Jdawg0309/CustomCPU/clockInfo.txt

-------------------------------------
| Tool Version : Vivado v.2026.1
| Date         : Mon Aug 31 18:38:04 2026
| Host         : junaet-desktop
| Design       : design_1
| Device       : xc7k480t-ffg901-2--
-------------------------------------

For more information on clockInfo.txt clock routing debug file see https://support.xilinx.com/s/article/000035660?language=en_US
