Jdawg0309/CustomCPU/build/harness_report.xlsx

Sheet: Summary
test | status | words | oracle_halted | hw_halted | ram_words_touched | mismatch_count | gaps | file
t01_loops_arrays | PASS | 82 | TRUE | TRUE | 12 | 0 |  | c_tests/aggressive/t01_loops_arrays.c
t02_bitops | PASS | 94 | TRUE | TRUE | 11 | 0 |  | c_tests/aggressive/t02_bitops.c
t03_recursion | HW_TIMEOUT | 98 | TRUE | FALSE | 38 | 18 | multiply | c_tests/aggressive/t03_recursion.c
t04_structs | PASS | 133 | TRUE | TRUE | 41 | 0 |  | c_tests/aggressive/t04_structs.c
t05_sorting | PASS | 156 | TRUE | TRUE | 29 | 0 |  | c_tests/aggressive/t05_sorting.c
t06_bytes_strings | DIFFER | 165 | TRUE | TRUE | 20 | 6 |  | c_tests/aggressive/t06_bytes_strings.c
t07_signed_math | PASS | 122 | TRUE | TRUE | 19 | 0 |  | c_tests/aggressive/t07_signed_math.c
t08_deep_calls | PASS | 79 | TRUE | TRUE | 7 | 0 |  | c_tests/aggressive/t08_deep_calls.c
t09_conditionals | PASS | 187 | TRUE | TRUE | 24 | 0 |  | c_tests/aggressive/t09_conditionals.c
t10_constants_pointers | PASS | 119 | TRUE | TRUE | 24 | 0 |  | c_tests/aggressive/t10_constants_pointers.c

Sheet: RAM diffs
test | ram_word | bus_addr | oracle | hardware | known_gap
t03_recursion | 0x00 | 0x1000 | 0x00000037 | 0x00000000 | multiply
t03_recursion | 0x02 | 0x1008 | 0x00000001 | 0x00000000 | multiply
t03_recursion | 0x03 | 0x100c | 0x00000078 | 0x00000000 | multiply
t03_recursion | 0x04 | 0x1010 | 0x00000001 | 0x00000000 | multiply
t03_recursion | 0x05 | 0x1014 | 0x00000006 | 0x00000000 | multiply
t03_recursion | 0x06 | 0x1018 | 0x00000015 | 0x00000000 | multiply
t03_recursion | 0xe7 | 0x139c | 0x00000002 | 0x00000004 | multiply
t03_recursion | 0xe8 | 0x13a0 | 0x00000000 | 0x00000002 | multiply
t03_recursion | 0xea | 0x13a8 | 0x00000003 | 0x00000005 | multiply
t03_recursion | 0xeb | 0x13ac | 0x00000003 | 0x00000005 | multiply
t03_recursion | 0xee | 0x13b8 | 0x00000002 | 0x00000006 | multiply
t03_recursion | 0xef | 0x13bc | 0x00000002 | 0x00000006 | multiply
t03_recursion | 0xf2 | 0x13c8 | 0x00000003 | 0x00000007 | multiply
t03_recursion | 0xf3 | 0x13cc | 0x00000003 | 0x00000007 | multiply
t03_recursion | 0xf6 | 0x13d8 | 0x00000002 | 0x00000008 | multiply
t03_recursion | 0xf8 | 0x13e0 | 0x00000036 | 0x00000022 | multiply
t03_recursion | 0xfa | 0x13e8 | 0x00001000 | 0x00000000 | multiply
t03_recursion | 0xfd | 0x13f4 | 0x00000094 | 0x00000070 | multiply
t06_bytes_strings | 0x00 | 0x1000 | 0x0000002b | 0x0000002c
t06_bytes_strings | 0x01 | 0x1004 | 0x0000002b | 0x0000002c
t06_bytes_strings | 0x02 | 0x1008 | 0x00000000 | 0xdf9a9800
t06_bytes_strings | 0x04 | 0x1010 | 0xfebfccb9 | 0x42255dec
t06_bytes_strings | 0x05 | 0x1014 | 0x00000022 | 0x00000028
t06_bytes_strings | 0xea | 0x13a8 | 0x20656854 | 0x00000054

Sheet: Known-gap hits
test | status | words | oracle_halted | hw_halted | ram_words_touched | mismatch_count | gaps | file
t03_recursion | HW_TIMEOUT | 98 | TRUE | FALSE | 38 | 18 | multiply | c_tests/aggressive/t03_recursion.c

Sheet: Compile errors
test | detail | file
