Jdawg0309/CustomCPU/build/isa_matrix_report.xlsx

Sheet: Summary
category | total | pass | fail
loadstore_lanes | 24 | 3 | 21
multiply | 28 | 4 | 24

Sheet: loadstore_lanes
case | status | detail | asm
ldrb_ram_lane0 | DIFFER | word 0x1: oracle=0x000000dd hw=0xaabbccdd | mov r1, #0x1000 ldr r2, =0xaabbccdd str r2, [r1] ldrb r0, [r1, #0] str r0, [r1, #4]
ldrb_rom_lane0 | DIFFER | word 0x1: oracle=0x000000dd hw=0xaabbccdd | ldr r1, =lit_word ldrb r0, [r1, #0] mov r4, #0x1000 str r0, [r4, #4] b 1f lit_word: .word 0xaabbccdd 1:
ldrb_ram_lane1 | DIFFER | word 0x1: oracle=0x000000cc hw=0xaabbccdd | mov r1, #0x1000 ldr r2, =0xaabbccdd str r2, [r1] ldrb r0, [r1, #1] str r0, [r1, #4]
ldrb_rom_lane1 | DIFFER | word 0x1: oracle=0x000000cc hw=0xaabbccdd | ldr r1, =lit_word ldrb r0, [r1, #1] mov r4, #0x1000 str r0, [r4, #4] b 1f lit_word: .word 0xaabbccdd 1:
ldrb_ram_lane2 | DIFFER | word 0x1: oracle=0x000000bb hw=0xaabbccdd | mov r1, #0x1000 ldr r2, =0xaabbccdd str r2, [r1] ldrb r0, [r1, #2] str r0, [r1, #4]
ldrb_rom_lane2 | DIFFER | word 0x1: oracle=0x000000bb hw=0xaabbccdd | ldr r1, =lit_word ldrb r0, [r1, #2] mov r4, #0x1000 str r0, [r4, #4] b 1f lit_word: .word 0xaabbccdd 1:
ldrb_ram_lane3 | DIFFER | word 0x1: oracle=0x000000aa hw=0xaabbccdd | mov r1, #0x1000 ldr r2, =0xaabbccdd str r2, [r1] ldrb r0, [r1, #3] str r0, [r1, #4]
ldrb_rom_lane3 | DIFFER | word 0x1: oracle=0x000000aa hw=0xaabbccdd | ldr r1, =lit_word ldrb r0, [r1, #3] mov r4, #0x1000 str r0, [r4, #4] b 1f lit_word: .word 0xaabbccdd 1:
strb_lane0 | PASS |  | mov r1, #0x1000 mov r2, #0 str r2, [r1] mov r3, #0x5A strb r3, [r1, #0] ldr r0, [r1] str r0, [r1, #4]
strb_lane1 | DIFFER | word 0x0: oracle=0x00005a00 hw=0x0000005a; word 0x1: oracle=0x00005a00 hw=0x0000005a | mov r1, #0x1000 mov r2, #0 str r2, [r1] mov r3, #0x5A strb r3, [r1, #1] ldr r0, [r1] str r0, [r1, #4]
strb_lane2 | DIFFER | word 0x0: oracle=0x005a0000 hw=0x0000005a; word 0x1: oracle=0x005a0000 hw=0x0000005a | mov r1, #0x1000 mov r2, #0 str r2, [r1] mov r3, #0x5A strb r3, [r1, #2] ldr r0, [r1] str r0, [r1, #4]
strb_lane3 | DIFFER | word 0x0: oracle=0x5a000000 hw=0x0000005a; word 0x1: oracle=0x5a000000 hw=0x0000005a | mov r1, #0x1000 mov r2, #0 str r2, [r1] mov r3, #0x5A strb r3, [r1, #3] ldr r0, [r1] str r0, [r1, #4]
ldrh_ram_lane0 | DIFFER | word 0x0: oracle=0xaabbccdd hw=0x0000aabb; word 0x1: oracle=0x0000ccdd hw=0x0000aabb | mov r1, #0x1000 ldr r2, =0xaabbccdd str r2, [r1] ldrh r0, [r1, #0] str r0, [r1, #4]
strh_lane0 | DIFFER | word 0x0: oracle=0x00001234 hw=0x12340000; word 0x1: oracle=0x00001234 hw=0x12340000 | mov r1, #0x1000 mov r2, #0 str r2, [r1] ldr r3, =0x1234 strh r3, [r1, #0] ldr r0, [r1] str r0, [r1, #4]
ldrh_ram_lane2 | DIFFER | word 0x0: oracle=0xaabbccdd hw=0xccddccdd; word 0x1: oracle=0x0000aabb hw=0x0000ccdd | mov r1, #0x1000 ldr r2, =0xaabbccdd str r2, [r1] ldrh r0, [r1, #2] str r0, [r1, #4]
strh_lane2 | DIFFER | word 0x0: oracle=0x12340000 hw=0x00001234; word 0x1: oracle=0x12340000 hw=0x00001234 | mov r1, #0x1000 mov r2, #0 str r2, [r1] ldr r3, =0x1234 strh r3, [r1, #2] ldr r0, [r1] str r0, [r1, #4]
ldrsb_lane0 | DIFFER | word 0x0: oracle=0x81828384 hw=0x00008182; word 0x1: oracle=0xffffff84 hw=0xffffff82 | mov r1, #0x1000 ldr r2, =0x81828384 str r2, [r1] ldrsb r0, [r1, #0] str r0, [r1, #4]
ldrsb_lane1 | DIFFER | word 0x0: oracle=0x81828384 hw=0x10008182; word 0x1: oracle=0xffffff83 hw=0xffffff81 | mov r1, #0x1000 ldr r2, =0x81828384 str r2, [r1] ldrsb r0, [r1, #1] str r0, [r1, #4]
ldrsb_lane2 | DIFFER | word 0x0: oracle=0x81828384 hw=0x83848384; word 0x1: oracle=0xffffff82 hw=0xffffff84 | mov r1, #0x1000 ldr r2, =0x81828384 str r2, [r1] ldrsb r0, [r1, #2] str r0, [r1, #4]
ldrsb_lane3 | DIFFER | word 0x0: oracle=0x81828384 hw=0x83840000; word 0x1: oracle=0xffffff81 hw=0xffffff83 | mov r1, #0x1000 ldr r2, =0x81828384 str r2, [r1] ldrsb r0, [r1, #3] str r0, [r1, #4]
ldrsh_lane0 | DIFFER | word 0x0: oracle=0x81828384 hw=0x00008182; word 0x1: oracle=0xffff8384 hw=0xffff8182 | mov r1, #0x1000 ldr r2, =0x81828384 str r2, [r1] ldrsh r0, [r1, #0] str r0, [r1, #4]
ldrsh_lane2 | DIFFER | word 0x0: oracle=0x81828384 hw=0x83848384; word 0x1: oracle=0xffff8182 hw=0xffff8384 | mov r1, #0x1000 ldr r2, =0x81828384 str r2, [r1] ldrsh r0, [r1, #2] str r0, [r1, #4]
strb_preindex_writeback | PASS |  | mov r1, #0x1000 add r1, r1, #4 mov r2, #0xAB strb r2, [r1, #-4]! mov r4, #0x1000 str r1, [r4, #8] ldr r0, [r1] str r0, [r4, #12]
strb_postindex | PASS |  | mov r1, #0x1000 mov r2, #0xCD strb r2, [r1], #4 mov r4, #0x1000 str r1, [r4, #8] ldr r0, [r1, #-4] str r0, [r4, #12]

Sheet: multiply
case | status | detail | asm
mul_0x7_0x6 | DIFFER | word 0x0: oracle=0x0000002a hw=0x00000000 | ldr r1, =0x00000007 ldr r2, =0x00000006 mul r0, r1, r2 mov r4, #0x1000 str r0, [r4]
mla_0x7_0x6 | DIFFER | word 0x0: oracle=0x0000102a hw=0x000001c0 | ldr r1, =0x00000007 ldr r2, =0x00000006 ldr r3, =0x1000 mla r0, r1, r2, r3 mov r4, #0x1000 str r0, [r4]
umull_0x7_0x6 | DIFFER | word 0x0: oracle=0x0000002a hw=0x000001c0 | ldr r2, =0x00000007 ldr r3, =0x00000006 umull r0, r1, r2, r3 mov r4, #0x1000 str r0, [r4] str r1, [r4, #4]
smull_0x7_0x6 | DIFFER | word 0x0: oracle=0x0000002a hw=0xfffffe3f | ldr r2, =0x00000007 ldr r3, =0x00000006 smull r0, r1, r2, r3 mov r4, #0x1000 str r0, [r4] str r1, [r4, #4]
mul_0x0_0x5 | PASS |  | ldr r1, =0x00000000 ldr r2, =0x00000005 mul r0, r1, r2 mov r4, #0x1000 str r0, [r4]
mla_0x0_0x5 | DIFFER | word 0x0: oracle=0x00001000 hw=0x00000000 | ldr r1, =0x00000000 ldr r2, =0x00000005 ldr r3, =0x1000 mla r0, r1, r2, r3 mov r4, #0x1000 str r0, [r4]
umull_0x0_0x5 | PASS |  | ldr r2, =0x00000000 ldr r3, =0x00000005 umull r0, r1, r2, r3 mov r4, #0x1000 str r0, [r4] str r1, [r4, #4]
smull_0x0_0x5 | DIFFER | word 0x0: oracle=0x00000000 hw=0xffffffff | ldr r2, =0x00000000 ldr r3, =0x00000005 smull r0, r1, r2, r3 mov r4, #0x1000 str r0, [r4] str r1, [r4, #4]
mul_0xffffffff_0x2 | DIFFER | word 0x0: oracle=0xfffffffe hw=0x00000000 | ldr r1, =0xffffffff ldr r2, =0x00000002 mul r0, r1, r2 mov r4, #0x1000 str r0, [r4]
mla_0xffffffff_0x2 | DIFFER | word 0x0: oracle=0x00000ffe hw=0xfffffffc | ldr r1, =0xffffffff ldr r2, =0x00000002 ldr r3, =0x1000 mla r0, r1, r2, r3 mov r4, #0x1000 str r0, [r4]
umull_0xffffffff_0x2 | DIFFER | word 0x0: oracle=0xfffffffe hw=0xfffffffc; word 0x1: oracle=0x00000001 hw=0x00000000 | ldr r2, =0xffffffff ldr r3, =0x00000002 umull r0, r1, r2, r3 mov r4, #0x1000 str r0, [r4] str r1, [r4, #4]
smull_0xffffffff_0x2 | DIFFER | word 0x0: oracle=0xfffffffe hw=0x00000003; word 0x1: oracle=0xffffffff hw=0x00000000 | ldr r2, =0xffffffff ldr r3, =0x00000002 smull r0, r1, r2, r3 mov r4, #0x1000 str r0, [r4] str r1, [r4, #4]
mul_0x80000000_0x2 | PASS |  | ldr r1, =0x80000000 ldr r2, =0x00000002 mul r0, r1, r2 mov r4, #0x1000 str r0, [r4]
mla_0x80000000_0x2 | DIFFER | word 0x0: oracle=0x00001000 hw=0x00000000 | ldr r1, =0x80000000 ldr r2, =0x00000002 ldr r3, =0x1000 mla r0, r1, r2, r3 mov r4, #0x1000 str r0, [r4]
umull_0x80000000_0x2 | DIFFER | word 0x1: oracle=0x00000001 hw=0x00000000 | ldr r2, =0x80000000 ldr r3, =0x00000002 umull r0, r1, r2, r3 mov r4, #0x1000 str r0, [r4] str r1, [r4, #4]
smull_0x80000000_0x2 | DIFFER | word 0x0: oracle=0x00000000 hw=0xffffffff; word 0x1: oracle=0xffffffff hw=0x00000000 | ldr r2, =0x80000000 ldr r3, =0x00000002 smull r0, r1, r2, r3 mov r4, #0x1000 str r0, [r4] str r1, [r4, #4]
mul_0x80000000_0x80000000 | PASS |  | ldr r1, =0x80000000 ldr r2, =0x80000000 mul r0, r1, r2 mov r4, #0x1000 str r0, [r4]
mla_0x80000000_0x80000000 | DIFFER | word 0x0: oracle=0x00001000 hw=0x80000000 | ldr r1, =0x80000000 ldr r2, =0x80000000 ldr r3, =0x1000 mla r0, r1, r2, r3 mov r4, #0x1000 str r0, [r4]
umull_0x80000000_0x80000000 | DIFFER | word 0x0: oracle=0x00000000 hw=0x80000000; word 0x1: oracle=0x40000000 hw=0x00000000 | ldr r2, =0x80000000 ldr r3, =0x80000000 umull r0, r1, r2, r3 mov r4, #0x1000 str r0, [r4] str r1, [r4, #4]
smull_0x80000000_0x80000000 | DIFFER | word 0x0: oracle=0x00000000 hw=0x7fffffff; word 0x1: oracle=0x40000000 hw=0x00000000 | ldr r2, =0x80000000 ldr r3, =0x80000000 smull r0, r1, r2, r3 mov r4, #0x1000 str r0, [r4] str r1, [r4, #4]
mul_0xffffffff_0xffffffff | DIFFER | word 0x0: oracle=0x00000001 hw=0x00000000 | ldr r1, =0xffffffff ldr r2, =0xffffffff mul r0, r1, r2 mov r4, #0x1000 str r0, [r4]
mla_0xffffffff_0xffffffff | DIFFER | word 0x0: oracle=0x00001001 hw=0x00000000 | ldr r1, =0xffffffff ldr r2, =0xffffffff ldr r3, =0x1000 mla r0, r1, r2, r3 mov r4, #0x1000 str r0, [r4]
umull_0xffffffff_0xffffffff | DIFFER | word 0x0: oracle=0x00000001 hw=0x00000000; word 0x1: oracle=0xfffffffe hw=0x00000000 | ldr r2, =0xffffffff ldr r3, =0xffffffff umull r0, r1, r2, r3 mov r4, #0x1000 str r0, [r4] str r1, [r4, #4]
smull_0xffffffff_0xffffffff | DIFFER | word 0x0: oracle=0x00000001 hw=0xffffffff | ldr r2, =0xffffffff ldr r3, =0xffffffff smull r0, r1, r2, r3 mov r4, #0x1000 str r0, [r4] str r1, [r4, #4]
mul_0x186a0_0x186a0 | DIFFER | word 0x0: oracle=0x540be400 hw=0x00000000 | ldr r1, =0x000186a0 ldr r2, =0x000186a0 mul r0, r1, r2 mov r4, #0x1000 str r0, [r4]
mla_0x186a0_0x186a0 | DIFFER | word 0x0: oracle=0x540bf400 hw=0x00000000 | ldr r1, =0x000186a0 ldr r2, =0x000186a0 ldr r3, =0x1000 mla r0, r1, r2, r3 mov r4, #0x1000 str r0, [r4]
umull_0x186a0_0x186a0 | DIFFER | word 0x0: oracle=0x540be400 hw=0x00000000; word 0x1: oracle=0x00000002 hw=0x00000000 | ldr r2, =0x000186a0 ldr r3, =0x000186a0 umull r0, r1, r2, r3 mov r4, #0x1000 str r0, [r4] str r1, [r4, #4]
smull_0x186a0_0x186a0 | DIFFER | word 0x0: oracle=0x540be400 hw=0xffffffff; word 0x1: oracle=0x00000002 hw=0x00000000 | ldr r2, =0x000186a0 ldr r3, =0x000186a0 smull r0, r1, r2, r3 mov r4, #0x1000 str r0, [r4] str r1, [r4, #4]
