Jdawg0309/CustomCPU/build/isa_matrix_report2.xlsx

Sheet: Summary
category | total | pass | fail
dp_immediate | 84 | 72 | 12
shifter | 112 | 53 | 59

Sheet: dp_immediate
case | status | detail | asm
and_s_imm_0x000000ff | PASS |  | mov r1, #0x55 ands r0, r1, #0xff mov r4, #0x1000 str r0, [r4] mov r6, #0 addmi r6, r6, #8 addeq r6, r6, #4 addcs r6, r6, #2 addvs r6, r6, #1 str r6, [r4, #4]
and_s_imm_0xff000000 | DIFFER | word 0x1: oracle=0x00000006 hw=0x00000004 | mov r1, #0x55 ands r0, r1, #0xff000000 mov r4, #0x1000 str r0, [r4] mov r6, #0 addmi r6, r6, #8 addeq r6, r6, #4 addcs r6, r6, #2 addvs r6, r6, #1 str r6, [r4, #4]
and_s_imm_0x0000ff00 | PASS |  | mov r1, #0x55 ands r0, r1, #0xff00 mov r4, #0x1000 str r0, [r4] mov r6, #0 addmi r6, r6, #8 addeq r6, r6, #4 addcs r6, r6, #2 addvs r6, r6, #1 str r6, [r4, #4]
and_s_imm_0xc0000000 | DIFFER | word 0x1: oracle=0x00000006 hw=0x00000004 | mov r1, #0x55 ands r0, r1, #0xc0000000 mov r4, #0x1000 str r0, [r4] mov r6, #0 addmi r6, r6, #8 addeq r6, r6, #4 addcs r6, r6, #2 addvs r6, r6, #1 str r6, [r4, #4]
and_s_imm_0x00000001 | PASS |  | mov r1, #0x55 ands r0, r1, #0x1 mov r4, #0x1000 str r0, [r4] mov r6, #0 addmi r6, r6, #8 addeq r6, r6, #4 addcs r6, r6, #2 addvs r6, r6, #1 str r6, [r4, #4]
and_s_imm_0x40000000 | PASS |  | mov r1, #0x55 ands r0, r1, #0x40000000 mov r4, #0x1000 str r0, [r4] mov r6, #0 addmi r6, r6, #8 addeq r6, r6, #4 addcs r6, r6, #2 addvs r6, r6, #1 str r6, [r4, #4]
and_s_imm_0x00000000 | PASS |  | mov r1, #0x55 ands r0, r1, #0x0 mov r4, #0x1000 str r0, [r4] mov r6, #0 addmi r6, r6, #8 addeq r6, r6, #4 addcs r6, r6, #2 addvs r6, r6, #1 str r6, [r4, #4]
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
mov_s_imm_0x0000ff00 | PASS |  | mov r0, #0x11 movs r0, #0xff00 mov r4, #0x1000 str r0, [r4] mov r6, #0 addmi r6, r6, #8 addeq r6, r6, #4 addcs r6, r6, #2 addvs r6, r6, #1 str r6, [r4, #4]
mov_s_imm_0xc0000000 | DIFFER | word 0x1: oracle=0x0000000a hw=0x00000008 | mov r0, #0x11 movs r0, #0xc0000000 mov r4, #0x1000 str r0, [r4] mov r6, #0 addmi r6, r6, #8 addeq r6, r6, #4 addcs r6, r6, #2 addvs r6, r6, #1 str r6, [r4, #4]
mov_s_imm_0x00000001 | PASS |  | mov r0, #0x11 movs r0, #0x1 mov r4, #0x1000 str r0, [r4] mov r6, #0 addmi r6, r6, #8 addeq r6, r6, #4 addcs r6, r6, #2 addvs r6, r6, #1 str r6, [r4, #4]
mov_s_imm_0x40000000 | PASS |  | mov r0, #0x11 movs r0, #0x40000000 mov r4, #0x1000 str r0, [r4] mov r6, #0 addmi r6, r6, #8 addeq r6, r6, #4 addcs r6, r6, #2 addvs r6, r6, #1 str r6, [r4, #4]
mov_s_imm_0x00000000 | PASS |  | mov r0, #0x11 movs r0, #0x0 mov r4, #0x1000 str r0, [r4] mov r6, #0 addmi r6, r6, #8 addeq r6, r6, #4 addcs r6, r6, #2 addvs r6, r6, #1 str r6, [r4, #4]
mvn_s_imm_0x000000ff | PASS |  | mov r0, #0x11 mvns r0, #0xff mov r4, #0x1000 str r0, [r4] mov r6, #0 addmi r6, r6, #8 addeq r6, r6, #4 addcs r6, r6, #2 addvs r6, r6, #1 str r6, [r4, #4]
mvn_s_imm_0xff000000 | DIFFER | word 0x1: oracle=0x00000002 hw=0x00000000 | mov r0, #0x11 mvns r0, #0xff000000 mov r4, #0x1000 str r0, [r4] mov r6, #0 addmi r6, r6, #8 addeq r6, r6, #4 addcs r6, r6, #2 addvs r6, r6, #1 str r6, [r4, #4]
mvn_s_imm_0x0000ff00 | PASS |  | mov r0, #0x11 mvns r0, #0xff00 mov r4, #0x1000 str r0, [r4] mov r6, #0 addmi r6, r6, #8 addeq r6, r6, #4 addcs r6, r6, #2 addvs r6, r6, #1 str r6, [r4, #4]
mvn_s_imm_0xc0000000 | DIFFER | word 0x1: oracle=0x00000002 hw=0x00000000 | mov r0, #0x11 mvns r0, #0xc0000000 mov r4, #0x1000 str r0, [r4] mov r6, #0 addmi r6, r6, #8 addeq r6, r6, #4 addcs r6, r6, #2 addvs r6, r6, #1 str r6, [r4, #4]
mvn_s_imm_0x00000001 | PASS |  | mov r0, #0x11 mvns r0, #0x1 mov r4, #0x1000 str r0, [r4] mov r6, #0 addmi r6, r6, #8 addeq r6, r6, #4 addcs r6, r6, #2 addvs r6, r6, #1 str r6, [r4, #4]
mvn_s_imm_0x40000000 | PASS |  | mov r0, #0x11 mvns r0, #0x40000000 mov r4, #0x1000 str r0, [r4] mov r6, #0 addmi r6, r6, #8 addeq r6, r6, #4 addcs r6, r6, #2 addvs r6, r6, #1 str r6, [r4, #4]
mvn_s_imm_0x00000000 | PASS |  | mov r0, #0x11 mvns r0, #0x0 mov r4, #0x1000 str r0, [r4] mov r6, #0 addmi r6, r6, #8 addeq r6, r6, #4 addcs r6, r6, #2 addvs r6, r6, #1 str r6, [r4, #4]

Sheet: shifter
case | status | detail | asm
movs_lsl_0_0x9a3c55f1 | PASS |  | ldr r1, =0x9a3c55f1 movs r0, r1, lsl #0 mov r4, #0x1000 str r0, [r4] mov r6, #0 addmi r6, r6, #8 addeq r6, r6, #4 addcs r6, r6, #2 addvs r6, r6, #1 str r6, [r4, #4]
movs_lsl_0_0xffffffff | PASS |  | ldr r1, =0xffffffff movs r0, r1, lsl #0 mov r4, #0x1000 str r0, [r4] mov r6, #0 addmi r6, r6, #8 addeq r6, r6, #4 addcs r6, r6, #2 addvs r6, r6, #1 str r6, [r4, #4]
movs_lsl_0_0x00000001 | PASS |  | ldr r1, =0x00000001 movs r0, r1, lsl #0 mov r4, #0x1000 str r0, [r4] mov r6, #0 addmi r6, r6, #8 addeq r6, r6, #4 addcs r6, r6, #2 addvs r6, r6, #1 str r6, [r4, #4]
movs_lsl_0_0x80000000 | PASS |  | ldr r1, =0x80000000 movs r0, r1, lsl #0 mov r4, #0x1000 str r0, [r4] mov r6, #0 addmi r6, r6, #8 addeq r6, r6, #4 addcs r6, r6, #2 addvs r6, r6, #1 str r6, [r4, #4]
movs_lsl_1_0x9a3c55f1 | DIFFER | word 0x1: oracle=0x00000002 hw=0x00000000 | ldr r1, =0x9a3c55f1 movs r0, r1, lsl #1 mov r4, #0x1000 str r0, [r4] mov r6, #0 addmi r6, r6, #8 addeq r6, r6, #4 addcs r6, r6, #2 addvs r6, r6, #1 str r6, [r4, #4]
movs_lsl_1_0xffffffff | DIFFER | word 0x1: oracle=0x0000000a hw=0x00000008 | ldr r1, =0xffffffff movs r0, r1, lsl #1 mov r4, #0x1000 str r0, [r4] mov r6, #0 addmi r6, r6, #8 addeq r6, r6, #4 addcs r6, r6, #2 addvs r6, r6, #1 str r6, [r4, #4]
movs_lsl_1_0x00000001 | PASS |  | ldr r1, =0x00000001 movs r0, r1, lsl #1 mov r4, #0x1000 str r0, [r4] mov r6, #0 addmi r6, r6, #8 addeq r6, r6, #4 addcs r6, r6, #2 addvs r6, r6, #1 str r6, [r4, #4]
movs_lsl_1_0x80000000 | DIFFER | word 0x1: oracle=0x00000006 hw=0x00000004 | ldr r1, =0x80000000 movs r0, r1, lsl #1 mov r4, #0x1000 str r0, [r4] mov r6, #0 addmi r6, r6, #8 addeq r6, r6, #4 addcs r6, r6, #2 addvs r6, r6, #1 str r6, [r4, #4]
movs_lsl_31_0x9a3c55f1 | PASS |  | ldr r1, =0x9a3c55f1 movs r0, r1, lsl #31 mov r4, #0x1000 str r0, [r4] mov r6, #0 addmi r6, r6, #8 addeq r6, r6, #4 addcs r6, r6, #2 addvs r6, r6, #1 str r6, [r4, #4]
movs_lsl_31_0xffffffff | DIFFER | word 0x1: oracle=0x0000000a hw=0x00000008 | ldr r1, =0xffffffff movs r0, r1, lsl #31 mov r4, #0x1000 str r0, [r4] mov r6, #0 addmi r6, r6, #8 addeq r6, r6, #4 addcs r6, r6, #2 addvs r6, r6, #1 str r6, [r4, #4]
movs_lsl_31_0x00000001 | PASS |  | ldr r1, =0x00000001 movs r0, r1, lsl #31 mov r4, #0x1000 str r0, [r4] mov r6, #0 addmi r6, r6, #8 addeq r6, r6, #4 addcs r6, r6, #2 addvs r6, r6, #1 str r6, [r4, #4]
movs_lsl_31_0x80000000 | PASS |  | ldr r1, =0x80000000 movs r0, r1, lsl #31 mov r4, #0x1000 str r0, [r4] mov r6, #0 addmi r6, r6, #8 addeq r6, r6, #4 addcs r6, r6, #2 addvs r6, r6, #1 str r6, [r4, #4]
movs_lsr_1_0x9a3c55f1 | DIFFER | word 0x1: oracle=0x00000002 hw=0x00000000 | ldr r1, =0x9a3c55f1 movs r0, r1, lsr #1 mov r4, #0x1000 str r0, [r4] mov r6, #0 addmi r6, r6, #8 addeq r6, r6, #4 addcs r6, r6, #2 addvs r6, r6, #1 str r6, [r4, #4]
movs_lsr_1_0xffffffff | DIFFER | word 0x1: oracle=0x00000002 hw=0x00000000 | ldr r1, =0xffffffff movs r0, r1, lsr #1 mov r4, #0x1000 str r0, [r4] mov r6, #0 addmi r6, r6, #8 addeq r6, r6, #4 addcs r6, r6, #2 addvs r6, r6, #1 str r6, [r4, #4]
movs_lsr_1_0x00000001 | DIFFER | word 0x1: oracle=0x00000006 hw=0x00000004 | ldr r1, =0x00000001 movs r0, r1, lsr #1 mov r4, #0x1000 str r0, [r4] mov r6, #0 addmi r6, r6, #8 addeq r6, r6, #4 addcs r6, r6, #2 addvs r6, r6, #1 str r6, [r4, #4]
movs_lsr_1_0x80000000 | PASS |  | ldr r1, =0x80000000 movs r0, r1, lsr #1 mov r4, #0x1000 str r0, [r4] mov r6, #0 addmi r6, r6, #8 addeq r6, r6, #4 addcs r6, r6, #2 addvs r6, r6, #1 str r6, [r4, #4]
movs_lsr_31_0x9a3c55f1 | PASS |  | ldr r1, =0x9a3c55f1 movs r0, r1, lsr #31 mov r4, #0x1000 str r0, [r4] mov r6, #0 addmi r6, r6, #8 addeq r6, r6, #4 addcs r6, r6, #2 addvs r6, r6, #1 str r6, [r4, #4]
movs_lsr_31_0xffffffff | DIFFER | word 0x1: oracle=0x00000002 hw=0x00000000 | ldr r1, =0xffffffff movs r0, r1, lsr #31 mov r4, #0x1000 str r0, [r4] mov r6, #0 addmi r6, r6, #8 addeq r6, r6, #4 addcs r6, r6, #2 addvs r6, r6, #1 str r6, [r4, #4]
movs_lsr_31_0x00000001 | PASS |  | ldr r1, =0x00000001 movs r0, r1, lsr #31 mov r4, #0x1000 str r0, [r4] mov r6, #0 addmi r6, r6, #8 addeq r6, r6, #4 addcs r6, r6, #2 addvs r6, r6, #1 str r6, [r4, #4]
movs_lsr_31_0x80000000 | PASS |  | ldr r1, =0x80000000 movs r0, r1, lsr #31 mov r4, #0x1000 str r0, [r4] mov r6, #0 addmi r6, r6, #8 addeq r6, r6, #4 addcs r6, r6, #2 addvs r6, r6, #1 str r6, [r4, #4]
movs_lsr_32_0x9a3c55f1 | DIFFER | word 0x0: oracle=0x00000000 hw=0x9a3c55f1; word 0x1: oracle=0x00000006 hw=0x00000008 | ldr r1, =0x9a3c55f1 movs r0, r1, lsr #32 mov r4, #0x1000 str r0, [r4] mov r6, #0 addmi r6, r6, #8 addeq r6, r6, #4 addcs r6, r6, #2 addvs r6, r6, #1 str r6, [r4, #4]
movs_lsr_32_0xffffffff | DIFFER | word 0x0: oracle=0x00000000 hw=0xffffffff; word 0x1: oracle=0x00000006 hw=0x00000008 | ldr r1, =0xffffffff movs r0, r1, lsr #32 mov r4, #0x1000 str r0, [r4] mov r6, #0 addmi r6, r6, #8 addeq r6, r6, #4 addcs r6, r6, #2 addvs r6, r6, #1 str r6, [r4, #4]
movs_lsr_32_0x00000001 | DIFFER | word 0x0: oracle=0x00000000 hw=0x00000001; word 0x1: oracle=0x00000004 hw=0x00000000 | ldr r1, =0x00000001 movs r0, r1, lsr #32 mov r4, #0x1000 str r0, [r4] mov r6, #0 addmi r6, r6, #8 addeq r6, r6, #4 addcs r6, r6, #2 addvs r6, r6, #1 str r6, [r4, #4]
movs_lsr_32_0x80000000 | DIFFER | word 0x0: oracle=0x00000000 hw=0x80000000; word 0x1: oracle=0x00000006 hw=0x00000008 | ldr r1, =0x80000000 movs r0, r1, lsr #32 mov r4, #0x1000 str r0, [r4] mov r6, #0 addmi r6, r6, #8 addeq r6, r6, #4 addcs r6, r6, #2 addvs r6, r6, #1 str r6, [r4, #4]
movs_asr_1_0x9a3c55f1 | DIFFER | word 0x1: oracle=0x0000000a hw=0x00000008 | ldr r1, =0x9a3c55f1 movs r0, r1, asr #1 mov r4, #0x1000 str r0, [r4] mov r6, #0 addmi r6, r6, #8 addeq r6, r6, #4 addcs r6, r6, #2 addvs r6, r6, #1 str r6, [r4, #4]
movs_asr_1_0xffffffff | DIFFER | word 0x1: oracle=0x0000000a hw=0x00000008 | ldr r1, =0xffffffff movs r0, r1, asr #1 mov r4, #0x1000 str r0, [r4] mov r6, #0 addmi r6, r6, #8 addeq r6, r6, #4 addcs r6, r6, #2 addvs r6, r6, #1 str r6, [r4, #4]
movs_asr_1_0x00000001 | DIFFER | word 0x1: oracle=0x00000006 hw=0x00000004 | ldr r1, =0x00000001 movs r0, r1, asr #1 mov r4, #0x1000 str r0, [r4] mov r6, #0 addmi r6, r6, #8 addeq r6, r6, #4 addcs r6, r6, #2 addvs r6, r6, #1 str r6, [r4, #4]
movs_asr_1_0x80000000 | PASS |  | ldr r1, =0x80000000 movs r0, r1, asr #1 mov r4, #0x1000 str r0, [r4] mov r6, #0 addmi r6, r6, #8 addeq r6, r6, #4 addcs r6, r6, #2 addvs r6, r6, #1 str r6, [r4, #4]
movs_asr_31_0x9a3c55f1 | PASS |  | ldr r1, =0x9a3c55f1 movs r0, r1, asr #31 mov r4, #0x1000 str r0, [r4] mov r6, #0 addmi r6, r6, #8 addeq r6, r6, #4 addcs r6, r6, #2 addvs r6, r6, #1 str r6, [r4, #4]
movs_asr_31_0xffffffff | DIFFER | word 0x1: oracle=0x0000000a hw=0x00000008 | ldr r1, =0xffffffff movs r0, r1, asr #31 mov r4, #0x1000 str r0, [r4] mov r6, #0 addmi r6, r6, #8 addeq r6, r6, #4 addcs r6, r6, #2 addvs r6, r6, #1 str r6, [r4, #4]
movs_asr_31_0x00000001 | PASS |  | ldr r1, =0x00000001 movs r0, r1, asr #31 mov r4, #0x1000 str r0, [r4] mov r6, #0 addmi r6, r6, #8 addeq r6, r6, #4 addcs r6, r6, #2 addvs r6, r6, #1 str r6, [r4, #4]
movs_asr_31_0x80000000 | PASS |  | ldr r1, =0x80000000 movs r0, r1, asr #31 mov r4, #0x1000 str r0, [r4] mov r6, #0 addmi r6, r6, #8 addeq r6, r6, #4 addcs r6, r6, #2 addvs r6, r6, #1 str r6, [r4, #4]
movs_asr_32_0x9a3c55f1 | DIFFER | word 0x0: oracle=0xffffffff hw=0x9a3c55f1; word 0x1: oracle=0x0000000a hw=0x00000008 | ldr r1, =0x9a3c55f1 movs r0, r1, asr #32 mov r4, #0x1000 str r0, [r4] mov r6, #0 addmi r6, r6, #8 addeq r6, r6, #4 addcs r6, r6, #2 addvs r6, r6, #1 str r6, [r4, #4]
movs_asr_32_0xffffffff | DIFFER | word 0x1: oracle=0x0000000a hw=0x00000008 | ldr r1, =0xffffffff movs r0, r1, asr #32 mov r4, #0x1000 str r0, [r4] mov r6, #0 addmi r6, r6, #8 addeq r6, r6, #4 addcs r6, r6, #2 addvs r6, r6, #1 str r6, [r4, #4]
movs_asr_32_0x00000001 | DIFFER | word 0x0: oracle=0x00000000 hw=0x00000001; word 0x1: oracle=0x00000004 hw=0x00000000 | ldr r1, =0x00000001 movs r0, r1, asr #32 mov r4, #0x1000 str r0, [r4] mov r6, #0 addmi r6, r6, #8 addeq r6, r6, #4 addcs r6, r6, #2 addvs r6, r6, #1 str r6, [r4, #4]
movs_asr_32_0x80000000 | DIFFER | word 0x0: oracle=0xffffffff hw=0x80000000; word 0x1: oracle=0x0000000a hw=0x00000008 | ldr r1, =0x80000000 movs r0, r1, asr #32 mov r4, #0x1000 str r0, [r4] mov r6, #0 addmi r6, r6, #8 addeq r6, r6, #4 addcs r6, r6, #2 addvs r6, r6, #1 str r6, [r4, #4]
movs_ror_1_0x9a3c55f1 | DIFFER | word 0x1: oracle=0x0000000a hw=0x00000008 | ldr r1, =0x9a3c55f1 movs r0, r1, ror #1 mov r4, #0x1000 str r0, [r4] mov r6, #0 addmi r6, r6, #8 addeq r6, r6, #4 addcs r6, r6, #2 addvs r6, r6, #1 str r6, [r4, #4]
movs_ror_1_0xffffffff | DIFFER | word 0x1: oracle=0x0000000a hw=0x00000008 | ldr r1, =0xffffffff movs r0, r1, ror #1 mov r4, #0x1000 str r0, [r4] mov r6, #0 addmi r6, r6, #8 addeq r6, r6, #4 addcs r6, r6, #2 addvs r6, r6, #1 str r6, [r4, #4]
movs_ror_1_0x00000001 | DIFFER | word 0x1: oracle=0x0000000a hw=0x00000008 | ldr r1, =0x00000001 movs r0, r1, ror #1 mov r4, #0x1000 str r0, [r4] mov r6, #0 addmi r6, r6, #8 addeq r6, r6, #4 addcs r6, r6, #2 addvs r6, r6, #1 str r6, [r4, #4]
movs_ror_1_0x80000000 | PASS |  | ldr r1, =0x80000000 movs r0, r1, ror #1 mov r4, #0x1000 str r0, [r4] mov r6, #0 addmi r6, r6, #8 addeq r6, r6, #4 addcs r6, r6, #2 addvs r6, r6, #1 str r6, [r4, #4]
movs_ror_31_0x9a3c55f1 | PASS |  | ldr r1, =0x9a3c55f1 movs r0, r1, ror #31 mov r4, #0x1000 str r0, [r4] mov r6, #0 addmi r6, r6, #8 addeq r6, r6, #4 addcs r6, r6, #2 addvs r6, r6, #1 str r6, [r4, #4]
movs_ror_31_0xffffffff | DIFFER | word 0x1: oracle=0x0000000a hw=0x00000008 | ldr r1, =0xffffffff movs r0, r1, ror #31 mov r4, #0x1000 str r0, [r4] mov r6, #0 addmi r6, r6, #8 addeq r6, r6, #4 addcs r6, r6, #2 addvs r6, r6, #1 str r6, [r4, #4]
movs_ror_31_0x00000001 | PASS |  | ldr r1, =0x00000001 movs r0, r1, ror #31 mov r4, #0x1000 str r0, [r4] mov r6, #0 addmi r6, r6, #8 addeq r6, r6, #4 addcs r6, r6, #2 addvs r6, r6, #1 str r6, [r4, #4]
movs_ror_31_0x80000000 | PASS |  | ldr r1, =0x80000000 movs r0, r1, ror #31 mov r4, #0x1000 str r0, [r4] mov r6, #0 addmi r6, r6, #8 addeq r6, r6, #4 addcs r6, r6, #2 addvs r6, r6, #1 str r6, [r4, #4]
movs_rrx_0x9a3c55f1 | DIFFER | word 0x0: oracle=0x4d1e2af8 hw=0x9a3c55f1; word 0x1: oracle=0x00000002 hw=0x00000008 | ldr r1, =0x9a3c55f1 movs r0, r1, rrx mov r4, #0x1000 str r0, [r4] mov r6, #0 addmi r6, r6, #8 addeq r6, r6, #4 addcs r6, r6, #2 addvs r6, r6, #1 str r6, [r4, #4]
movs_rrx_0xffffffff | DIFFER | word 0x0: oracle=0x7fffffff hw=0xffffffff; word 0x1: oracle=0x00000002 hw=0x00000008 | ldr r1, =0xffffffff movs r0, r1, rrx mov r4, #0x1000 str r0, [r4] mov r6, #0 addmi r6, r6, #8 addeq r6, r6, #4 addcs r6, r6, #2 addvs r6, r6, #1 str r6, [r4, #4]
movs_rrx_0x00000001 | DIFFER | word 0x0: oracle=0x00000000 hw=0x00000001; word 0x1: oracle=0x00000006 hw=0x00000000 | ldr r1, =0x00000001 movs r0, r1, rrx mov r4, #0x1000 str r0, [r4] mov r6, #0 addmi r6, r6, #8 addeq r6, r6, #4 addcs r6, r6, #2 addvs r6, r6, #1 str r6, [r4, #4]
movs_rrx_0x80000000 | DIFFER | word 0x0: oracle=0x40000000 hw=0x80000000; word 0x1: oracle=0x00000000 hw=0x00000008 | ldr r1, =0x80000000 movs r0, r1, rrx mov r4, #0x1000 str r0, [r4] mov r6, #0 addmi r6, r6, #8 addeq r6, r6, #4 addcs r6, r6, #2 addvs r6, r6, #1 str r6, [r4, #4]
movs_reg_lsl_amt0_0x9a3c55f1 | PASS |  | ldr r1, =0x9a3c55f1 mov r3, #0 movs r0, r1, lsl r3 mov r4, #0x1000 str r0, [r4] mov r6, #0 addmi r6, r6, #8 addeq r6, r6, #4 addcs r6, r6, #2 addvs r6, r6, #1 str r6, [r4, #4]
movs_reg_lsl_amt0_0xffffffff | PASS |  | ldr r1, =0xffffffff mov r3, #0 movs r0, r1, lsl r3 mov r4, #0x1000 str r0, [r4] mov r6, #0 addmi r6, r6, #8 addeq r6, r6, #4 addcs r6, r6, #2 addvs r6, r6, #1 str r6, [r4, #4]
movs_reg_lsl_amt1_0x9a3c55f1 | DIFFER | word 0x1: oracle=0x00000002 hw=0x00000000 | ldr r1, =0x9a3c55f1 mov r3, #1 movs r0, r1, lsl r3 mov r4, #0x1000 str r0, [r4] mov r6, #0 addmi r6, r6, #8 addeq r6, r6, #4 addcs r6, r6, #2 addvs r6, r6, #1 str r6, [r4, #4]
movs_reg_lsl_amt1_0xffffffff | DIFFER | word 0x1: oracle=0x0000000a hw=0x00000008 | ldr r1, =0xffffffff mov r3, #1 movs r0, r1, lsl r3 mov r4, #0x1000 str r0, [r4] mov r6, #0 addmi r6, r6, #8 addeq r6, r6, #4 addcs r6, r6, #2 addvs r6, r6, #1 str r6, [r4, #4]
movs_reg_lsl_amt31_0x9a3c55f1 | PASS |  | ldr r1, =0x9a3c55f1 mov r3, #31 movs r0, r1, lsl r3 mov r4, #0x1000 str r0, [r4] mov r6, #0 addmi r6, r6, #8 addeq r6, r6, #4 addcs r6, r6, #2 addvs r6, r6, #1 str r6, [r4, #4]
movs_reg_lsl_amt31_0xffffffff | DIFFER | word 0x1: oracle=0x0000000a hw=0x00000008 | ldr r1, =0xffffffff mov r3, #31 movs r0, r1, lsl r3 mov r4, #0x1000 str r0, [r4] mov r6, #0 addmi r6, r6, #8 addeq r6, r6, #4 addcs r6, r6, #2 addvs r6, r6, #1 str r6, [r4, #4]
movs_reg_lsl_amt32_0x9a3c55f1 | DIFFER | word 0x1: oracle=0x00000006 hw=0x00000004 | ldr r1, =0x9a3c55f1 mov r3, #32 movs r0, r1, lsl r3 mov r4, #0x1000 str r0, [r4] mov r6, #0 addmi r6, r6, #8 addeq r6, r6, #4 addcs r6, r6, #2 addvs r6, r6, #1 str r6, [r4, #4]
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
movs_reg_ror_amt255_0x9a3c55f1 | PASS |  | ldr r1, =0x9a3c55f1 mov r3, #255 movs r0, r1, ror r3 mov r4, #0x1000 str r0, [r4] mov r6, #0 addmi r6, r6, #8 addeq r6, r6, #4 addcs r6, r6, #2 addvs r6, r6, #1 str r6, [r4, #4]
movs_reg_ror_amt255_0xffffffff | DIFFER | word 0x1: oracle=0x0000000a hw=0x00000008 | ldr r1, =0xffffffff mov r3, #255 movs r0, r1, ror r3 mov r4, #0x1000 str r0, [r4] mov r6, #0 addmi r6, r6, #8 addeq r6, r6, #4 addcs r6, r6, #2 addvs r6, r6, #1 str r6, [r4, #4]
movs_reg_ror_amt256_0x9a3c55f1 | PASS |  | ldr r1, =0x9a3c55f1 mov r3, #256 movs r0, r1, ror r3 mov r4, #0x1000 str r0, [r4] mov r6, #0 addmi r6, r6, #8 addeq r6, r6, #4 addcs r6, r6, #2 addvs r6, r6, #1 str r6, [r4, #4]
movs_reg_ror_amt256_0xffffffff | PASS |  | ldr r1, =0xffffffff mov r3, #256 movs r0, r1, ror r3 mov r4, #0x1000 str r0, [r4] mov r6, #0 addmi r6, r6, #8 addeq r6, r6, #4 addcs r6, r6, #2 addvs r6, r6, #1 str r6, [r4, #4]
