Jdawg0309/CustomCPU/fpga/fmax/tight_setup_hold_pins.txt

+====================+===================+=======================+
| Launch Setup Clock | Launch Hold Clock | Pin                   |
+====================+===================+=======================+
| clk                | clk               | cpu/cspr/_4__reg[2]/D |
+--------------------+-------------------+-----------------------+
