Jdawg0309/CustomCPU/tight_setup_hold_pins.txt

+====================+===================+============================================================+
| Launch Setup Clock | Launch Hold Clock | Pin                                                        |
+====================+===================+============================================================+
| npu_clk            | npu_clk           | dut/gen_rows[23].gen_cols[1].pe/dsp_accumulator_reg[25]/D  |
| npu_clk            | npu_clk           | dut/gen_rows[24].gen_cols[4].pe/dsp_accumulator_reg[29]/D  |
| npu_clk            | npu_clk           | dut/gen_rows[17].gen_cols[2].pe/dsp_accumulator_reg[29]/D  |
| npu_clk            | npu_clk           | dut/gen_rows[22].gen_cols[4].pe/dsp_accumulator_reg[31]/D  |
| npu_clk            | npu_clk           | dut/gen_rows[23].gen_cols[1].pe/dsp_accumulator_reg[29]/D  |
| npu_clk            | npu_clk           | dut/gen_rows[8].gen_cols[4].pe/dsp_accumulator_reg[29]/D   |
| npu_clk            | npu_clk           | dut/gen_rows[20].gen_cols[3].pe/dsp_accumulator_reg[29]/D  |
| npu_clk            | npu_clk           | dut/gen_rows[9].gen_cols[7].pe/dsp_accumulator_reg[29]/D   |
| npu_clk            | npu_clk           | dut/gen_rows[24].gen_cols[4].pe/dsp_accumulator_reg[31]/D  |
| npu_clk            | npu_clk           | dut/gen_rows[22].gen_cols[1].pe/dsp_accumulator_reg[29]/D  |
| npu_clk            | npu_clk           | dut/gen_rows[23].gen_cols[1].pe/dsp_accumulator_reg[24]/D  |
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
| npu_clk            | npu_clk           | dut/gen_rows[5].gen_cols[0].pe/dsp_accumulator_reg[24]/D   |
| npu_clk            | npu_clk           | dut/gen_rows[28].gen_cols[18].pe/dsp_accumulator_reg[21]/D |
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
