Jdawg0309/CustomCPU/(list of files, drawings)

Other design files:
ALU_modular_design.circ
arm_custom_subset.circ
arm_subset_debug.circ
armv4t.circ
armv4t_2.circ
armv4t_ANNOTATED.circ
build/aggressive_2026-11-04/deep/001/t.circ
build/aggressive_2026-11-04/deep/002/t.circ
build/aggressive_2026-11-04/deep/003/t.circ
build/aggressive_2026-11-04/deep/004/t.circ
build/aggressive_2026-11-04/deep/005/t.circ
build/aggressive_2026-11-04/deep/006/t.circ
build/aggressive_2026-11-04/deep/007/t.circ
build/aggressive_2026-11-04/deep/008/t.circ
build/aggressive_2026-11-04/deep/009/t.circ
build/aggressive_2026-11-04/deep/010/t.circ
build/aggressive_2026-11-04/deep/011/t.circ
build/aggressive_2026-11-04/deep/012/t.circ
build/aggressive_2026-11-04/deep/013/t.circ
build/aggressive_2026-11-04/deep/014/t.circ
build/aggressive_2026-11-04/deep/015/t.circ
build/aggressive_2026-11-04/deep/016/t.circ
build/aggressive_2026-11-04/deep/017/t.circ
build/aggressive_2026-11-04/deep/018/t.circ
build/aggressive_2026-11-04/deep/019/t.circ
build/aggressive_2026-11-04/deep/020/t.circ
build/aggressive_2026-11-04/deep/021/t.circ
build/aggressive_2026-11-04/deep/022/t.circ
build/aggressive_2026-11-04/deep/023/t.circ
build/aggressive_2026-11-04/deep/024/t.circ
build/aggressive_2026-11-04/deep/025/t.circ
build/aggressive_2026-11-04/deep/026/t.circ
build/aggressive_2026-11-04/deep/027/t.circ
build/aggressive_2026-11-04/deep/028/t.circ
build/aggressive_2026-11-04/deep/029/t.circ
build/aggressive_2026-11-04/deep/030/t.circ
build/aggressive_2026-11-04/deep/031/t.circ
build/aggressive_2026-11-04/deep/032/t.circ
build/aggressive_2026-11-04/deep/033/t.circ
build/aggressive_2026-11-04/deep/034/t.circ
build/aggressive_2026-11-04/deep/035/t.circ
build/aggressive_2026-11-04/deep/036/t.circ
build/aggressive_2026-11-04/deep/037/t.circ
build/aggressive_2026-11-04/deep/038/t.circ
build/aggressive_2026-11-04/deep/039/t.circ
build/aggressive_2026-11-04/deep/040/t.circ
build/aggressive_2026-11-04/deep/041/t.circ
build/aggressive_2026-11-04/deep/042/t.circ
build/aggressive_2026-11-04/deep/043/t.circ
build/aggressive_2026-11-04/deep/044/t.circ
build/aggressive_2026-11-04/deep/045/t.circ
build/aggressive_2026-11-04/deep/046/t.circ
build/aggressive_2026-11-04/deep/047/t.circ
build/aggressive_2026-11-04/deep/048/t.circ
build/aggressive_2026-11-04/deep/049/t.circ
build/aggressive_2026-11-04/deep/050/t.circ
build/aggressive_2026-11-04/deep/051/t.circ
build/aggressive_2026-11-04/deep/052/t.circ
build/aggressive_2026-11-04/deep/053/t.circ
build/aggressive_2026-11-04/deep/054/t.circ
build/aggressive_2026-11-04/deep/055/t.circ
build/aggressive_2026-11-04/deep/056/t.circ
build/aggressive_2026-11-04/deep/057/t.circ
build/aggressive_2026-11-04/deep/058/t.circ
build/aggressive_2026-11-04/deep/059/t.circ
build/aggressive_2026-11-04/deep/060/t.circ
build/aggressive_2026-11-04/deep/061/t.circ
build/aggressive_2026-11-04/deep/062/t.circ
build/aggressive_2026-11-04/deep/063/t.circ
build/aggressive_2026-11-04/deep/064/t.circ
build/aggressive_2026-11-04/deep/065/t.circ
build/aggressive_2026-11-04/deep/066/t.circ
build/aggressive_2026-11-04/deep/067/t.circ
build/aggressive_2026-11-04/deep/068/t.circ
build/aggressive_2026-11-04/deep/069/t.circ
build/aggressive_2026-11-04/deep/070/t.circ
build/aggressive_2026-11-04/deep/071/t.circ
build/aggressive_2026-11-04/deep/072/t.circ
build/aggressive_2026-11-04/deep/073/t.circ
build/aggressive_2026-11-04/deep/074/t.circ
build/aggressive_2026-11-04/deep/075/t.circ
build/aggressive_2026-11-04/deep/076/t.circ
build/aggressive_2026-11-04/deep/077/t.circ
build/aggressive_2026-11-04/deep/078/t.circ
build/aggressive_2026-11-04/deep/079/t.circ
build/aggressive_2026-11-04/deep/080/t.circ
build/aggressive_2026-11-04/deep/081/t.circ
build/aggressive_2026-11-04/deep/082/t.circ
build/aggressive_2026-11-04/deep/083/t.circ
build/aggressive_2026-11-04/deep/084/t.circ
build/aggressive_2026-11-04/deep/085/t.circ
build/aggressive_2026-11-04/deep/086/t.circ
build/aggressive_2026-11-04/deep/087/t.circ
build/aggressive_2026-11-04/deep/088/t.circ
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
