Jdawg0309/CustomCPU/(commit log)

2026-06-27 Prune main to ALU_modular_design.circ; full tree archived in archive/pre-prune
    [ALU_32_bit.circ, ALU_modular_design.circ, Adder4bit.circ, CPU_noram.circ, CPU_round2 (copy).circ, CPU_round2.circ, Subtractor4Bit.circ, Subtractor8Bit.circ]
2026-07-06 Update armv4t.circ; add ALU software model and opcode ROM
    - armv4t.circ: latest in-use Logisim design
    - armv4t_alu.py: software oracle for the CustomCPU V2 ARMv4T ALU
    - opcode: Logisim hex ROM image
    [armv4t.circ]
2026-07-08 Add gate-level 32x32 multiplier engine into ALU
    partial_products (32 AND rows) -> csa_reduction_chain (30x 3:2 carry-save
    compressors) -> ks_32b final add. Wired into ALU out_mux slot 10 (engine_sel=10)
    as a third engine alongside logic and arithmetic. Verified: 0xDEADBEEF^2=0x216DA321,
    0xFFFFFFFF^2=0x1, 255^2=0xFE01, 13x11=0x8F.
    [armv4t.circ]
2026-07-09 Import register file + PC fetch into V2 datapath
    Carried reg16x32 (16x32, 2-read/1-write) and pc_fetch over from the V1 build
    (ALU_modular_design.circ) into armv4t.circ and re-verified them in place.
    Datapath now at 25%; barrel shifter is the next and only genuinely-new block.
    README progress bars updated (overall 40%).
    [armv4t.circ]
2026-07-09 Gate-level 4x4 systolic NPU: replace black-box Multiplier/Adder in PE_cell
    PE_cell now uses mul_32b (carry-save, hand-built) + ks_32b (Kogge-Stone) instead of
    Logisim's built-in Multiplier and Adder. matmul4x4's hardwired Constant 0xF weight
    replaced with 16 real weight inputs (w00..w33). Identity test passes: diagonal w=1,
    a=(1,2,3,4) -> outputs 1,2,3,4.
    Every gate from matmul4x4 down to the last AND is now hand-built. The multiplier is
    the shared primitive: the CPU's MUL and the NPU's MAC are the same circuit.
    Cost: ~7,300 gates x 16 PEs = ~117,000 gates.
    [armv4t.circ]
2026-07-09 Fix dropped-carry bug in mul_32; add INT8 mul_8b blocks
    mul_32 was exporting the CSA chain's raw (sum, carry) vectors instead of the resolved
    product. The ALU took only 'sum' into out_mux slot 10, and PE_cell did the same. This
    passed DEADBEEF^2 and 9E3779B9*7F4A7C15 as FALSE POSITIVES because their final carry
    happens to be zero; 0xFFFFFFFF^2 exposed it (gave 0x80000001 instead of 0x00000001).
    Fix: ks_32b moved inside mul_32, which now exports a single product(32) pin. The ALU's
    slot 10 gets the real product, and PE_cell's existing ks_32b becomes the accumulator
    (product + psum_in). Verified: ALU 0xFFFFFFFF^2 = 0x1; PE_cell w=5,a=7,psum=3 -> 0x26.
    Also added INT8 multiplier blocks: pp_row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
    [armv4t.circ]
2026-07-09 Generate decode ROM from the oracle TABLE; add MUL entry
    armv4t_alu.py gains rom_word(), rom_image(), --rom and --decoder. The ROM image
    is now derived from the 16-op TABLE instead of hand-typed; the generated words
    reproduce the previous ROM byte-for-byte (regression checked).
    Adds MUL as engine_sel=10 at ROM address 0x10, word 0x201. MUL is not a
    data-processing opcode (ARM encodes it with opcode[24:21]==0000, colliding with
    AND, distinguished by bits[7:4]==1001), so the ROM address widens to 5 bits with
    bit4 = is_MUL. ROM data width must be 10 to hold 0x201.
    Rewrites opcode: 4097 lines of mostly-zeros -> 32 words, and clears the stale
    duplicates of BIC/MVN that were sitting at 0x10/0x11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
2026-07-09 Add barrel shifter oracle: barrel_shift(), --shift, --shiftproof
    Models the 5-stage logarithmic barrel shifter exactly as it will be built
    (stage k shifts by 2^k iff amt[k]==1, with type-dependent fill), plus a direct
    single-shot reference. --shiftproof checks staged == direct across 10 vectors x
    4 types x 32 amounts = 1280 combinations: 0 mismatches. This proves the
    composition invariant (ASR never changes bit31, so per-stage sign fill is
    correct; rotations add mod 32) BEFORE any gate is laid.
2026-07-09 Offline packet: assembler, datapath diagram, full build guide
    asm.py - tiny ARMv4T data-processing assembler + oracle simulator. Encodes the
    register-form instructions the single-cycle CPU can run today, emits a
    Logisim ROM image, and prints expected register values per clock.
    blockdiag.py - adds cpu_datapath() : the whole single-cycle datapath on one sheet.
    BUILD_CPU.md - staged walkthrough (fetch->decode->regs->ALU->writeback), the
    verify probe at each stage, a debug order, and every trap this project
    has actually hit (splitter bits, Sign-vs-Zero extender, 3-in XOR parity,
    dropped carry, tunnel shorts, lib-ID mismatch).
    All of it runs wit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
2026-07-14 M1: the single-cycle CPU executes instructions
    Integrated the datapath in armv4t.circ:
    pc_fetch -> instr_rom -> splitters -> decode_rom -> reg16x32 -> ALU -> writeback.
    Wired per BUILD_CPU.md. ADD R3,R5,R4 -> R3 = 0x00000008. It's alive.
    Add boot_rom: a self-bootstrapping 16-instruction bring-up program that needs
    NO poked registers. Every register resets to 0, so the program manufactures its
    own constants: MVN R1,R0 turns the reset-zero into 0xFFFFFFFF, then
    SUB R2,R0,R1 (0 - 0xFFFFFFFF) yields a ONE, and an ADD chain builds the rest.
    Ends R3=8, then exercises every remaining engine path.
    It carries the two discriminators that a plain 5+3 test cannot see:
    - SUB R2,R0,R1 is the ONLY inst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
    [armv4t.circ]
2026-08-04 Complete pre-memory ARMv4T CPU regression
    [armv4t.circ]
2026-08-04 Add conditional ARMv4T LDR STR memory path
    [armv4t.circ]
2026-08-05 Add ARM pre and post-index memory addressing
    [armv4t.circ]
2026-08-05 Add ARM base writeback control
    [armv4t.circ]
2026-08-06 Complete stack store writeback checkpoint
    [armv4t.circ]
2026-08-10 Checkpoint dual-write register file
    [armv4t.circ]
2026-08-13 Complete stack load writeback and RAM timing fix
    [armv4t.circ]
2026-08-14 Add practical C suite and block transfer controller
    [armv4t.circ]
2026-08-14 Add block transfer register list selection
    [armv4t.circ]
2026-08-14 Connect block transfer register list in main
    [armv4t.circ]
2026-08-17 Tidy block-transfer probe layout in main; add netlist-diff tool and staged stack/recursion test ROMs
    Repositioned block_transfer_control and its probes in main (connectivity
    verified unchanged via tools/circuit_graph.py), fixed the block_class_bits
    probe label typo, and added a small netlist query script used to check it.
    Also stages three PUSH/POP ROMs (single-register, multi-register, and a
    recursive Fibonacci) in stack_recursion_tests/ to validate the remaining
    block-transfer RAM connect and SP writeback work.
    [armv4t.circ]
2026-08-17 Add block-transfer address counter and RAM/writeback enable signals
    Inside block_transfer_control: a base_value input, an address_reg counter
    with dec4/inc4 (STMDB pre-decrement / LDMIA post-increment), and new
    transfer_address, final_address, store_enable, and load_enable outputs.
    Verified terminal-exact via tools/circuit_graph.py. Not yet wired into
    main, so this has no effect on CPU behavior until that follow-up lands.
    [armv4t.circ]
2026-08-19 Wire and verify block-transfer PUSH store datapath in main
    Add the RAM address override mux, write-enable OR gate, and reg_idx-selected
    RD_B source connecting block_transfer_control to the RAM/register file, and
    fix two address-stepping bugs (accept_start select, missing hold path on
    stepped_addr) found while tracing a stuck transfer_address.
    Verified with a 10-ROM PUSH discriminator suite: 9/10 pass, including a full
    14-register push. The one expected failure is two sequential push
    instructions, since SP writeback to the register file isn't wired yet.
    [armv4t.circ]
2026-08-20 Find and isolate a combinational cycle in mul_32's CSA tree
    The oscillation that has been blocking block-transfer work is not a
    block-transfer bug. Minimal repro is three ROM words with no memory access
    and no block transfer:
    e3a0107f e0810001 e12fff1e mov r1,#0x7F; add r0,r1,r1; bx lr
    It reproduces identically on ef985e6, so it predates the block-transfer
    datapath entirely.
    Localized by forcing signals to constants in a scratch copy: pinning ks_32b's
    operands changed nothing, pinning mul_32's operands removed the oscillation in
    every failing case, and pinning partial_products' 32 outputs did too.
    Minimizing the live partial-product set yields p2..p6, all five required. The
    defect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
    [armv4t.circ]
2026-08-20 Swap ALU adder to a built-in: ALU 63->98 MHz, CPU 45->58 MHz
    Rebuilt ALU_arithmetic_engine on Logisim's built-in Adder in place of the
    hand-built Kogge-Stone prefix adder. Routed Artix-7 timing (F4PGA/VPR on
    xc7a100tcsg324-1):
    ALU 63.37 -> 98.12 MHz (15.78 -> 10.19 ns), 321 -> 176 LUT
    CPU 45.34 -> 58.31 MHz (22.06 -> 17.15 ns)
    +55% on the ALU and +29% on the CPU while shrinking the ALU by 45%. The cause
    is visible in the primitive counts: the ALU's CARRY4 usage goes 0 -> 9. A
    hand-built parallel-prefix adder cannot reach the FPGA's dedicated carry chain
    and maps entirely to LUTs and MUXF6. Correct on an ASIC, wrong on an FPGA.
    Isolated A/B on the same harness confirms the mechanis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
    [armv4t.circ]
2026-08-20 Complete the block-transfer stack: POP works end to end
    Three wiring changes in armv4t.circ, each verified before the next:
    1. main: register write-enable mux select -> hold_pc OR done, so the normal
    single-cycle datapath cannot commit during a block transfer. Without it
    `pop {r1,r2}` silently destroyed r0: the block instruction is also decoded
    as a data-processing op whose Rd is instr[15:12] of the register list.
    E8BD____ lands on opcode 0101 (ADC, writes) while E92D____ lands on 1001
    (TEQ-class, no write) -- the only reason PUSH was ever safe.
    2. block_transfer_control: address hold-mux select ->
    reg_selected AND (index_advancing OR terminal), instead of bare
    reg_sel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
    [armv4t.circ]
2026-08-21 Add a provenance tool that makes the circuit's history legible
    armv4t.circ is one large XML file, so `git diff` on it is thousands of lines
    of <wire from=...> and communicates nothing. The construction history is the
    strongest evidence of how this design was actually built, and it was
    effectively invisible.
    tools/provenance.py walks every revision of the circuit and reports structural
    change instead of XML: which subcircuits appeared, which gained or lost
    components and wires, and how the design grew overall. `--diff A B` gives a
    component-level semantic diff between any two revisions; `--csv` emits
    per-revision metrics.
    PROVENANCE.md is generated from it. The record shows the design growi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
2026-08-21 Add vestigial-structure scanner, timeline docs, and signing config
    tools/vestigial.py finds structure left behind by earlier edits: circuits
    defined but never instantiated, splitters whose bus end drives nothing, and a
    superseded circuit beside its replacement. It separates reliable checks from a
    geometry-based heuristic and labels the heuristic honestly -- it flagged
    bs_stage_16 as unwired, which prompted the first test of shift amounts above 4.
    All six passed, so the shifter is correct and the finding was spurious. The
    check is kept as a source of leads rather than dressed up as fact.
    PROVENANCE.md now states the hand-wiring claim precisely. The imprecise version
    -- that circuit commits a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
2026-08-21 State the hand-wiring claim without an absolutist assertion
    PROVENANCE.md previously claimed no automated process had ever written to
    armv4t.circ. That was an over-strong generalisation from one session's tooling
    discipline, and an absolute claim of that shape needs an asterisk it does not
    need to carry.
    The section now states what is true and sufficient: all circuit design and
    wiring was performed by the author by hand in Logisim Evolution, and AI
    assistance was used for verification tooling and debugging analysis.
    It also keeps the correction made earlier -- circuit commits are not cleanly
    separated from tooling commits, which is checkable in one git log, so the
    document says so rather t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
2026-08-21 Add a generated audit of every AI file write in the repository
    tools/ai_audit.py scans every Claude Code session transcript on the machine,
    filters to paths under this repository, and records every Write/Edit/MultiEdit
    call. AI_CONTRIBUTIONS.md is generated from it.
    The result across 11 transcripts touching this project: AI wrote tooling (5
    files), test programs (3), documentation (8), and FPGA synthesis scaffolding
    around HDL exported from the author's circuit. In armv4t.circ itself -- 24
    revisions, 1,261 components -- AI wrote two things, both on 2026-08-17: the
    final_address output pin in block_transfer_control and the wire attaching it to
    a net that already existed.
    That wire is worth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
2026-08-21 Reposition the reg_selected AND gate and tidy its wiring
    Moves the AND gate driving reg_selected from (2000,1960) to (2030,1960) and
    reroutes five wires. Layout only -- no logic change. Verified: SP after push
    and after pop correct at all six list widths.
    [armv4t.circ]
2026-08-21 Prune main to the design, ROMs and their sources
    Main now carries only what constitutes the CPU and what reproduces it:
    armv4t.circ, the ROM trees (cpu/, regression_roms/, math_roms/,
    stack_recursion_tests/), the C and assembly sources, and the ROM build scripts.
    138 files, down from 244.
    Removed from main: 28 root markdown documents, tools/, docs/, generated
    diagrams (.png/.svg), .dump/.o/.bin build artefacts, __pycache__, and 32 loose
    ROM files at the repository root that duplicated regression_roms/ and cpu/ byte
    for byte.
    None of it is lost. Everything remains on the archive/full-2026-08-21 branch --
    including PROJECT_LOG.md, PROJECT_STATUS.md, ROADMAP.md, PROVENANCE.md,
    AI_CONTRIBUTION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
2026-08-21 Flatten the ROM tree and attribute authorship
    All ROM images now live in a single flat roms/ directory, their sources in
    src/, and the build and verification scripts in build/. This dedupes the tree:
    regression_roms/ and math_roms/ were byte-identical copies of the cpu/ images
    under different names, 22 duplicate groups in total, so 66 ROM files collapse
    to 43 unique ones.
    Build scripts repointed at the new layout and verified: make -C build verify
    rebuilds the math ROMs and validates all 36 images.
    Three test programs (01_push_pop_single, 02_push_pop_multi, 03_fib_recursive)
    are removed from main. They were AI-authored, per the audit on the archive
    branch, and both their sources and ROMs r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
    [armv4t_ANNOTATED.circ, debug_armv4t.circ]
2026-08-21 Make the PC writable: mov pc,rN and ldr pc,[..] now work
    A write whose destination register is r15 now redirects the program counter,
    using the absolute-branch path that already existed for BX.
    In main: a 4-bit comparator tests the register-file write address against 0xf,
    ANDed with the write enable to give pc_write. That drives three things --
    a mux selecting the write data onto pc_fetch.abs_target, an OR onto
    abs_select, and an OR onto BRANCH.
    The BRANCH term is the one that is easy to miss. Inside pc_fetch the mux chain
    is abs_select (which kind of target) -> BRANCH (branch at all) -> hold. With
    BRANCH low the second mux passes PC+4 and discards the absolute target
    entirely, so abs_sele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
    [armv4t.circ]
2026-08-21 Untrack the debug scratch copy
    debug_armv4t.circ is a working copy of armv4t.circ used for diagnosis -- it is
    regenerated from the real circuit whenever something needs probing, and it
    carries taps and experimental wiring that are not part of the design. Tracking
    it means every diagnostic session shows up as a circuit change.
    Also ignores armv4t_ANNOTATED.circ, the generated marker copy.
    Neither is authoritative; armv4t.circ is.
    [debug_armv4t.circ]
2026-08-21 Track debug_armv4t.circ
    The debug copy is kept in the repository at the author's request. It is a
    working mirror of armv4t.circ used for diagnosis -- probes, taps and
    experimental wiring get built there so the real circuit is never modified
    during investigation.
    armv4t.circ remains the authoritative design; debug_armv4t.circ is
    regenerated from it whenever something needs probing, so the two are
    identical except while an experiment is in progress.
    [debug_armv4t.circ]
2026-08-21 Disclose two AI edits to armv4t.circ
    On 2026-08-17 at 20:04 UTC an AI assistant made two direct edits to
    armv4t.circ, against the standing rule that the circuit is hand-wired and AI
    works only on copies: an output pin (final_address) in block_transfer_control
    and one wire attaching it to a net that already existed. Both were committed
    unnoticed in ef985e6 and are still in the circuit.
    Two components out of 1,261 across 33 subcircuits -- 0.16%. The wire branched
    the author's own existing net out to a new port rather than joining two pieces
    of logic, so no AI-made connection links logic elements in this design.
    Established by searching every Claude Code transcript on the machine for
    file-edi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
2026-08-21 Remove AI_EDIT_DISCLOSURE.md
    Withdrawn. The file was added in e84edc1 and stated that two AI edits had been
    made to armv4t.circ. That count was wrong -- a later, wider audit of the session
    transcripts found five writes, not two. The first audit searched for Write/Edit
    tool calls and for shell redirects, tee, sed -i, cp and mv, and so missed three
    python heredocs using open('armv4t.circ','w') on 2026-08-18.
    Those three wrote a phase-machine patch into block_transfer_control: a
    PHASE_REG register, an XOR gate, a NOT gate, two gating gates, load_enable
    widened to a 3-input AND, and roughly sixteen wires. None of it survives. Every
    component and wire from that patch is absent from the circuit t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
2026-08-24 Complete stack returns and add circuit validation
    [armv4t.circ, debug_armv4t.circ]
2026-08-26 Add reorganized and sandbox CPU circuits
    [armv4t_2.circ, sandbox.circ]
2026-08-27 Complete execute stage in reorganized CPU
    [armv4t_2.circ]
2026-08-27 Checkpoint CPU before memory stage wiring
    [armv4t_2.circ]
2026-08-27 Complete memory stage in reorganized CPU
    [armv4t_2.circ]
2026-08-28 Wire reorganized ARM core main with tunnel nets
    [armv4t_2.circ]
2026-08-28 Add variable register shifts to reorganized CPU
    [armv4t_2.circ]
2026-08-28 working on multiplier at the moment
    [armv4t.circ, armv4t_2.circ, debug_armv4t.circ, debug_armv4t_2.circ, debug_armv4t_2_baseline.circ, debug_armv4t_2_multiply.circ, debug_armv4t_2_shift.circ, debug_armv4t_2_varshift_trace.circ]
2026-09-01 Checkpoint halfword transfer wiring progress
    [armv4t_2.circ]
2026-09-05 Step 0 bring-up + sub-word loads + linker memory-map fix
    armv4t_2.circ:
    - Wire DATA_RAM.data_in / data_out (were completely unconnected -- every
    store/load was observably a no-op; push_suite/pop_suite/isa_coverage were
    effectively unmeasurable before this).
    - Tie DATA_RAM.be0-be3 to a constant 1 so ordinary word stores assert all
    byte lanes (byte-enable RAM needs them driven; real per-size lane control
    is still a follow-up).
    - Build the LDRH/STRH/LDRSB byte/halfword extract-and-extend network in
    stage_MEM (byte-lane splitter + select mux + sign extend, halfword
    splitter + select mux + zero/sign extend, SH-field result mux), gated
    into load_data by is_hwxfer. Matches debug_armv4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
    [armv4t_2.circ]
2026-09-05 Fix halfword memory corruption and ordinary byte loads
    Gate halfword writes to stores, correct STRH placement and lane enables, and select zero-extended LDRB data from RAM or ROM. Verified 22/26 focused Logisim checks; remaining four failures are the known STRB neighbor-preservation gap. All eight RAM/ROM LDRB matrix cases pass.
    [armv4t_2.circ]
2026-09-07 Complete STRB data routing and byte-enable selection
    Repeat the low store byte, select the addressed lane, and preserve word and halfword store enables. Verified 26/26 focused real-Logisim memory/control checks and 24/24 Unicorn memory comparisons. Architectural regression: 51/54; MUL, MLA, and SWP remain failing. Shifter and flag limitations remain tracked separately.
    [armv4t_2.circ]
2026-09-17 current work
    [arm_custom_subset.circ, arm_subset_debug.circ, armv4t_2.circ, debug_armv4t_2.circ, harness_report.xlsx, isa_matrix_lanes_fixed.xlsx, isa_matrix_report.xlsx, isa_matrix_report2.xlsx]
2026-09-24 Wire operand2 carry audit fix
    [arm_custom_subset.circ]
2026-09-24 Add pre-multiply ARM sandbox and wiring guide
    [arm_custom_subset_pre_mul.circ]
2026-11-07 Fix unaligned ARM word loads and retain D2 verification
2026-11-08 Record post-D2 ARM-state baseline and remaining memory-path defects
2026-11-08 Fix ROM halfword loads with selected memory word
    Route LDRH/LDRSH extraction through a dedicated D2_WORD splitter while retaining the raw RAM store merge path. Circuit wiring was edited manually by the user.
    Validation: direct Logisim ROM probes 14/14; directed memory, flags, alignment and PC/stack regressions 53/53.
